zjucsxxd/MRF49XA-Dongle/README

See http://alternet.us.com/?page_id=1494
