zjucsxxd/MRF49XA-Dongle/mrf49xa-small-v2.jpg

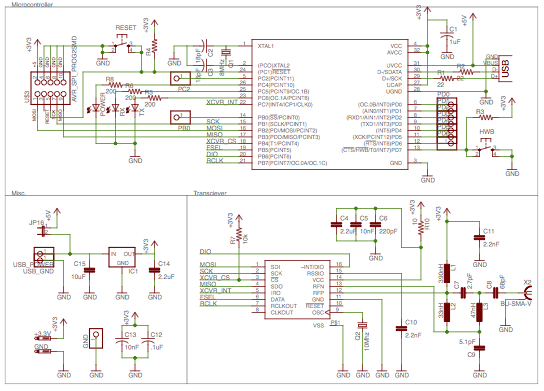
mrf49xa-small-v2.jpg
