zjucsxxd/MRF49XA-Dongle/Screen Shot 2015-04-04 at 8.13.55 AM.png

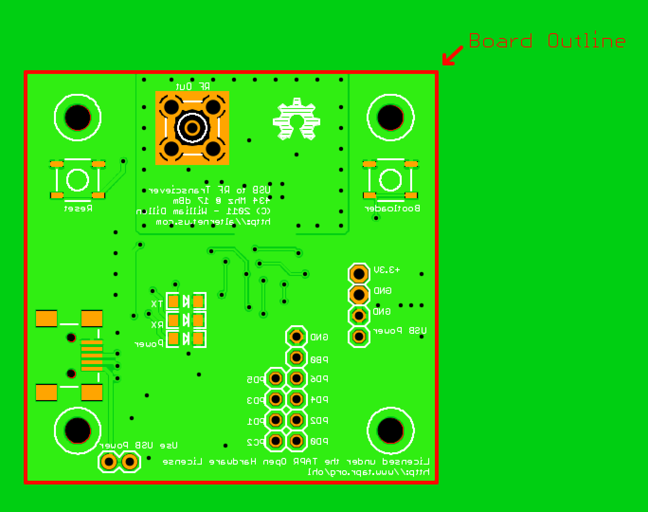
Screen Shot 2015-04-04 at 8.13.55 AM.png
