zjucsxxd/MRF49XA-Dongle/tuning.numbers/preview-web.jpg

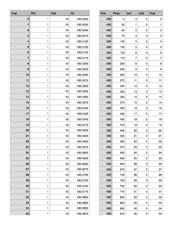
tuning.numbers/preview-web.jpg
