zjucsxxd/MRF49XA-Dongle/tuning.numbers/preview.jpg

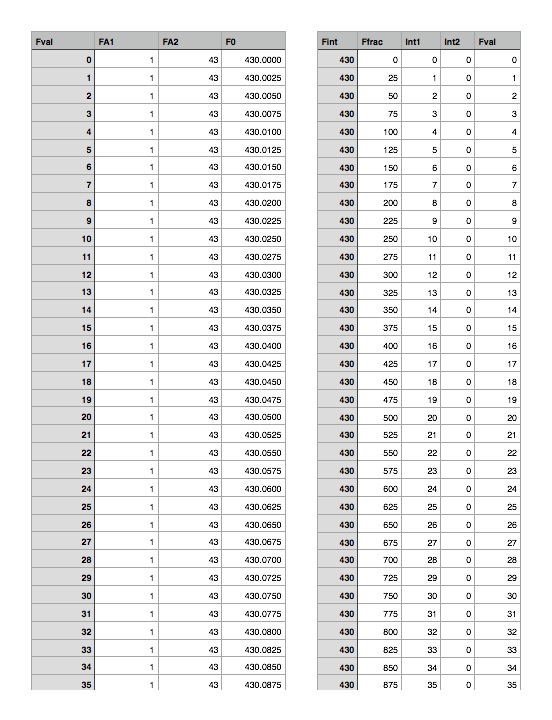
tuning.numbers/preview.jpg
