zjucsxxd/MRF49XA-Dongle/mrf49xa-small-v2.pdf

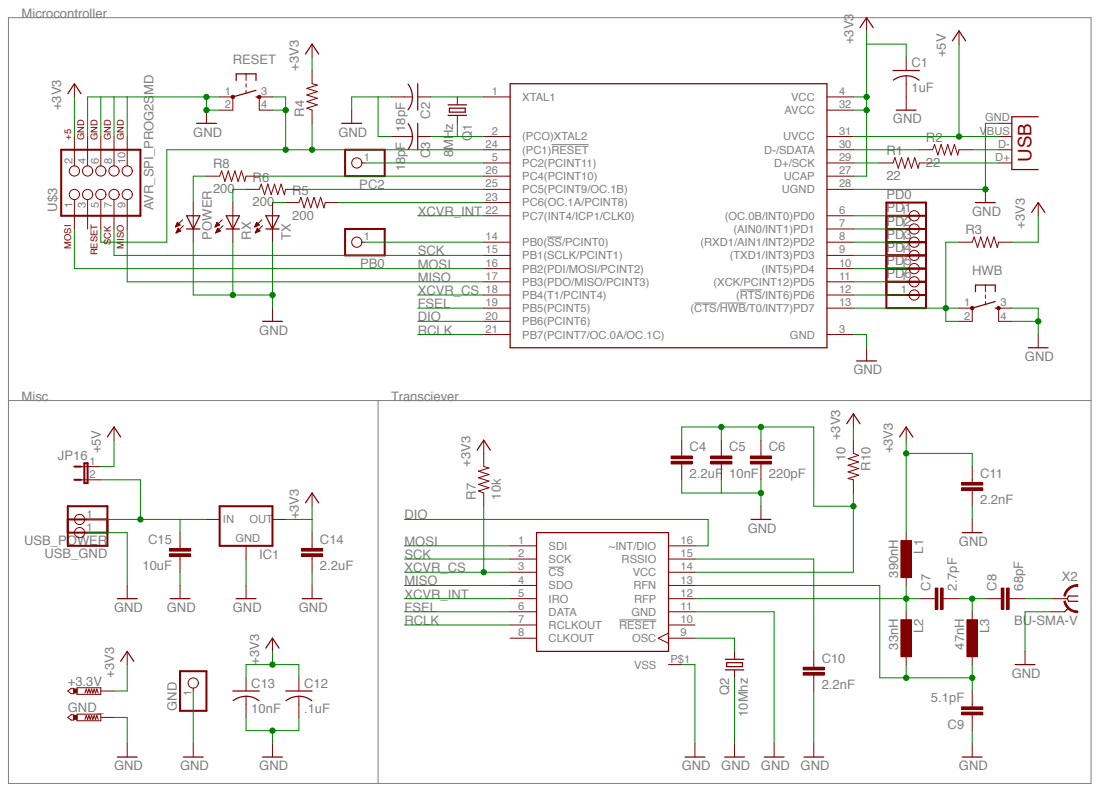
[picture p6: page 1]
