zjucsxxd/MRF49XA-Dongle/(commit log)

2011-11-25 Added the beginning for the useful part of main.c. All it does now is collect bytes from the USB system, toggling an LED once for each byte. Also includes the beginning of the function that collected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
2011-11-26 Test of basic packet assembly works: reading bytes from the USB into a buffer, generating the FEC code, etc... For now, it sends the packet back out of the USB for testing.
2011-11-27 Disabled the hardware SPI peripheral. There was some weird thing that was preventing system initialization. It worked fine when the logic analyzer was connected, but not otherwise. This is something 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
    [hardware.h]
2011-11-27 Got alternating, ones and zeros transmitting successfully. Packet-based transmission still doesn't work, though.
    [MRF49XA.c, MRF49XA.h]
2011-11-27 Messed around with the init sequence a bit to try and nail-down the SPI problem. Added some basic code to set different transmission modes (alternating, ones and zeros) for testing.
    [main.c]
2011-11-27 An error cropped up in the hardware file. The AT90USBKey needs the int4 pin to be Port E4. Also, corrected the FSEL definition
    [hardware.h]
2011-11-28 Added conditional defines to support the USBKey board and the beta bored.
2011-11-28 I think I've got commented-out defines for the beta board
2011-12-03 Made minor fixes to various arithmetic operations. The packet output was verified using a logic analyzer to be what is expected.
    [MRF49XA.c]
2011-12-03 Fixed an omission in the packet assembly function that would set the appropriate value for the pad field. Without this, random locations in memory would be used in the calculation of the ECC. Added a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
    [main.c]
2011-12-16 Changed the LED definitions to be more consistent
2011-12-16 Changed the entire packet format. Went back to the pre-error control days. These chips just don't have the RAM to make it work.
    [MRF49XA.c]
2011-12-16 Made the 8-bit SPI read a little more explicit
2011-12-18 Fixed the string length properties of the device descriptor.
    [Descriptors.c]
2011-12-18 Re-arranged the MCU and BOARD defines because they are modified at the same time (and often) Changed the optimization level to try to address weird bugs. (probably didn't help) Changed the avrdude po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
2011-12-18 Enabled the break functionality Started using the MRF hardware.h file for LED port and pin information Finished basic work on main function and packet assembly Separated the packet transmission over 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
2011-12-18 Added LED information
2011-12-18 Fixed a bug related to transmitting packets. The last byte wasn't being transmitted before transmission is shutdown.
    [MRF49XA.c]
2012-01-27 Adding error correction coding
    [main.c]
2014-03-12 Added several source files, and disabled CDC interrupts. Optimization set to small, and changed to using macports avr-gcc
2014-03-12 Experimentation with the SPI code
2014-03-12 Removed form USBKey stuff that isn’t used anymore.
2014-03-12 Fixed some copy-paste crap
    [MRF49XA_definitions.h]
2014-03-13 Fixed a weird issue with the transmit buffer. Seems to be working correctly now.
    [MRF49XA.c, MRF49XA.h]
2014-03-13 Using the arduino avr-size because it provides percentages Fixed the flag for programming eeprom using dfu-programmer
2014-03-13 Added a global ticks counter to help keep track of time in the main loop. Changed the meaning of the break command (goes to menu) Added a newline to the labels of the packet trace output Changed from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
    [main.c]
2014-03-13 Basic transparent serial operation seems to be working. There’s bytes that are sent out over CDC during transmit.
2014-03-13 Just adding some starting code on packet mode. It’s nowhere near ready.
2014-03-13 Moved the flow control functions to a more logical location
2014-03-16 Hacked-on support the UART
2015-04-04 Added hardware design files
    [mrf49xa-small-v2.brd, mrf49xa-small-v2.sch]
