zjucsxxd/MRF49XA-Dongle/(notices)

Notices in the files:
main.c:
modify it under the terms of the GNU General Public License
